adrihigu/Proyecto-afinador/README.md

# EC3882. Afinador Musical

  El presente proyecto consiste en el diseño e implementación de un afinador musical, para detectar el tono musical de un sonido recibido a través de un micrófono sensor y luego mostrarlo en pantalla en tiempo real. El usuario será capaz de indicar la nota musical que desee para compararlo con el tono medido, de forma que este pueda visualizar mediante la interfaz de usuario si está por debajo o por encima de la tonalidad señalada.

Páginas de documentación:

Voice Tuner and its Effects (Nitin Sitaraman, Emmanuel Denloye)

https://people.ece.cornell.edu/land/courses/ece4760/FinalProjects/s2009/ns325_eod2/ns325_eod2/index.html

A Real-Time Audio Processing Framework in Java (University College Ghent, School of Arts. University Ghent, IPEM.)

http://0110.be/tag/TarsosDSP
https://github.com/JorenSix/TarsosDSP
