adrihigu/Proyecto-afinador/Imagenes/Captura13_1.png

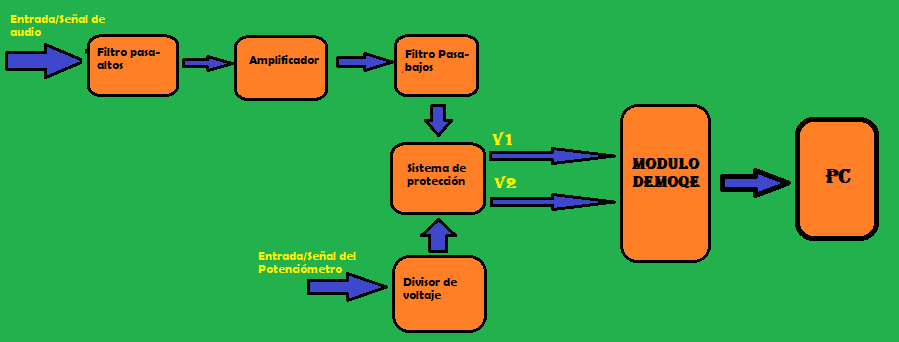
Imagenes/Captura13_1.png
