adrihigu/Proyecto-afinador/Imagenes/Captura13_2.png

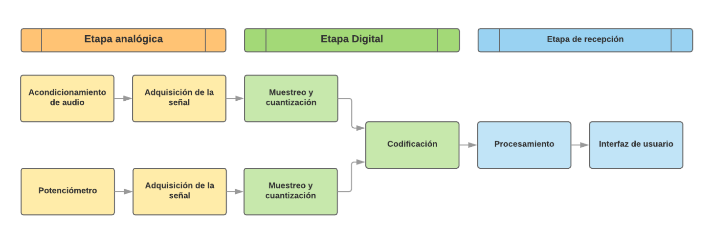
Imagenes/Captura13_2.png
