adrihigu/Proyecto-afinador/(list of files, drawings)

Other design files:
Documentación/Parte analógica/Diseño_Final_Higuerey_Garrido.ms13
Documentación/Parte analógica/Diseño_sensor_potenciometro_Higuerey_Garrido.ms13
