adrihigu/Proyecto-afinador/Documentación/Pruebas del micrófono/Entrega 3/220 Hz. Sinusoidal.PNG

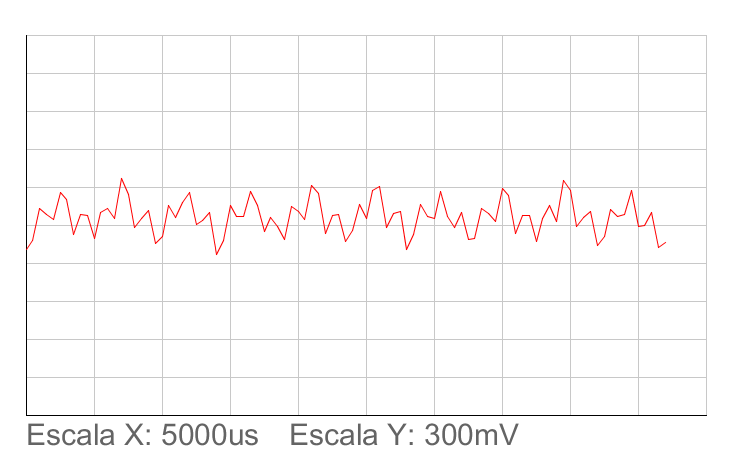
Documentación/Pruebas del micrófono/Entrega 3/220 Hz. Sinusoidal.PNG
