adrihigu/Proyecto-afinador/Documentación/Pruebas del micrófono/Entrega 3/500 Hz. Sinusoidal.PNG

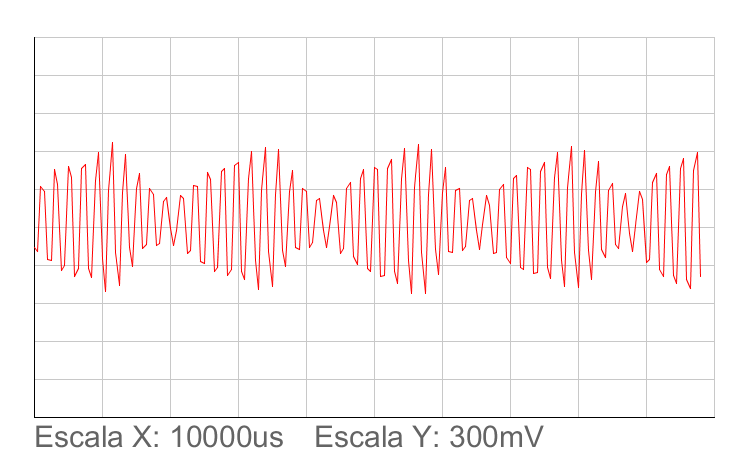
Documentación/Pruebas del micrófono/Entrega 3/500 Hz. Sinusoidal.PNG
