adrihigu/Proyecto-afinador/Documentación/Pruebas del micrófono/Entrega 3/1000 Hz. sinusoidal.PNG

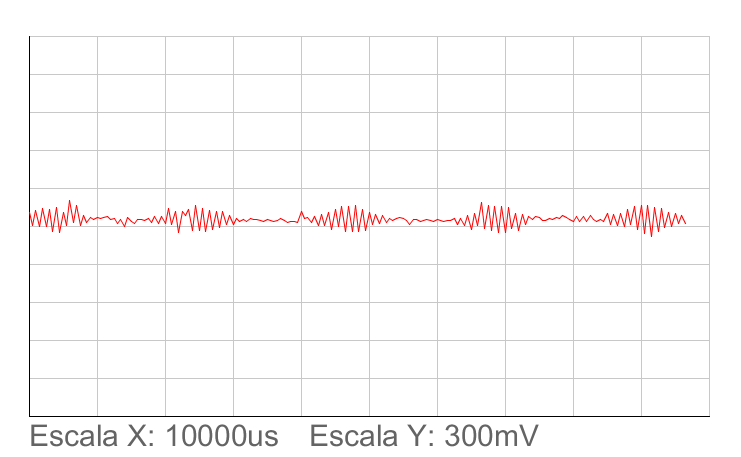
Documentación/Pruebas del micrófono/Entrega 3/1000 Hz. sinusoidal.PNG
